vic80-designs/vic80_iButton_copier/Readme.md

# 🔑 Умный автономный копировщик 1-Wire ключей DS1990 на ATmega8 (asm)

Универсальный портативный дубликатор электронных ключей формата DS1990 (iButton), написанный на чистом низкоуровневом ассемблере AVR. Главная отличительная особенность проекта — функция **ручного поразрядного ввода уникального ID**, позволяющая создать работающий дубликат на болванке даже в том случае, если оригинальный ключ был утерян.

Проект разработан в рамках концепции "чистого DIY" (минималистичное железо и максимальная оптимизация кода), полностью автономен и проверен в реальной эксплуатации.

## 🚀 Ключевые особенности

* **Копирование без оригинала:** Возможность вручную набрать 64-битный код ключа (например, по записям из базы ТСЖ, ЖКХ или договора) и зашить его в болванку.
* **Аппаратный минимализм:** Всё управление завязано всего на три тактовые кнопки, а логика переходов реализована на базе эффективного конечного автомата (state machine) на ассемблере.
* **Автоматический расчет CRC-8:** При ручном вводе или редактировании идентификатора, байт контрольной суммы (два самых левых HEX-символа на дисплее) пересчитывается автоматически «на лету» по алгоритму Далласа. Отредактировать его вручную или ошибиться в контрольной сумме невозможно.
* **Интеллектуальная подсветка:** Реализован софтверный таймер активности. Если в течение 3 секунд устройство не используется (нет нажатий клавиш или операций чтения/записи), подсветка экрана WH1602 плавно гаснет для экономии энергии. При любом действии она мгновенно просыпается.
* **Программная локализация:** Интерфейс полностью русифицирован. Для дисплеев без встроенной поддержки кириллицы недостающие русские символы динамически генерируются и прописываются в CGRAM память контроллера HD44780 при старте.
* **Эргономичная индикация:** Считыватель снабжен двухцветным светодиодом (красный/зеленый) и пьезоэлектрическим зуммером, которые наглядно сигнализируют о статусе операции: долгий одиночный писк (успех) или серия из 5 коротких сигналов (ошибка).

## 📊 Режимы работы устройства

Переключение между режимами осуществляется кнопками «Влево» / «Вправо» по циклическому списку в верхнем ряду дисплея (выбираемый режим выделен угловыми скобками `< >`). Активация режима — по кнопке «Ввод» (при этом скобки исчезают).

1. **`< ЧТЕНИЕ >`** — Ожидание прикладывания оригинального ключа DS1990. При успешном чтении HEX-код выводится в нижнюю строку и сохраняется в оперативной памяти устройства до выключения питания.
2. **`< ЗАПИСЬ >`** — Режим прошивки болванок (поддерживаются RW1990 / TM01). Если память пуста, на экране на 3 секунды высветится надпись `ПУСТО` и прибор вернется в меню. Если же код в памяти есть, светодиод замигает, приглашая к действию: прислоняем болванку — и готово.
3. **`< РЕДАКТИРОВАНИЕ >`** — Поразрядный HEX-ввод. Кнопками «Влево» / «Вправо» выбирается полубайт (подсвечивается нижним подчеркиванием `_`), по нажатию кнопки «Ввод» курсор меняется на мигающий квадрат, позволяя изменять значение от `0` до `F`. Выход из режима — удержание кнопки «Ввод» более 3 секунд.

## 📁 Структура репозитория

* 📁 **Firmware/Bin** — Готовая скомпилированная прошивка в формате `iButtonCopier.hex` для быстрой заливки в микроконтроллер.
* 📁 **Firmware/Source_Code** — Полноценный проект для среды **Microchip Studio (Atmel Studio)** со всеми исходными файлами на чистом ассемблере AVR (`.asm`).
* 📁 **Schematics** — Принципиальная электрическая схема устройства, выполненная в среде EasyEDA. Доступна в форматах **PDF** (для качественной печати) и **PNG** (для быстрого просмотра).
* 📁 **PCB** — Файлы печатной платы: стандартизированный Gerber-архив в формате `.zip` для заказа плат на фабриках (JLCPCB, NextPCB и др.).

## ⚙ Настройка Fuse-битов при прошивке (Критически важно!)

Для правильной работы программных задержек протокола 1-Wire и таймингов опроса дисплея, микроконтроллер ATmega8 должен тактоваться от **внешнего кварцевого резонатора на 4.0 МГц** с конденсаторами обвязки. Наличие или настройка встроенного BOD-детектора в данном проекте роли не играет, так как данные в EEPROM не записываются.

Рекомендуемые конфигурационные байты фьюзов для внешнего кварца 4 МГц:

| Программа / Метод | Low Fuse | High Fuse |
| :--- | :---: | :---: |
| **AVRDUDE / Консоль** | **0xED** | **0xD9** |
| **eXtreme Burner** | **0xED** | **0xD9** |
| **AVR8 Burn-O-Mat** | **ED** | **D9** |

*Примечание: Выставленный Low Fuse 0xED настраивает МК на работу от внешнего среднечастотного кварца (CKSEL=1101) с максимальным временем задержки старта (SUT=10) для стабильного запуска генератора. Перед прошивкой обязательно сверяйтесь с картой фьюзов вашей конкретной утилиты.*

## 🔌 Рекомендации по схемотехнике и питанию

* **Управление узлами:** Для разгрузки портов ввода-вывода ATmega8 управление пьезоэлектрическим зуммером со встроенным генератором реализовано через классический транзисторный ключ (n-p-n). 
* **Подсветка LCD:** Ток подсветки экранов WH1602 может достигать 100 мА. На финальной схеме управление подсветкой выведено через отдельный биполярный транзистор, что полностью исключает перегрузку и деградацию пинов МК.
* **Стабилизация напряжения:** Схема питания спроектирована на импульсном DC-DC стабилизаторе **MC34063**. Это обеспечивает высокий КПД при питании устройства от внешних источников напряжением 9–12 В или батарей типа «Крона», предотвращая избыточный нагрев элементов схемы, свойственный линейным стабилизаторам типа 7805.
* **Фильтрация:** Обязательно устанавливайте блокировочный керамический конденсатор номиналом 0.1 мкФ в непосредственной близости к выводам питания микроконтроллера `VCC` и `GND`.

## ⚠ Дисклеймер и техническое примечание

**Проект предоставляется на условиях «As Is» (Как есть).** Автор не несет никакой ответственности за возможный ущерб имуществу, СКУД-системам, третьим лицам или за любое неправомерное использование данного прибора. Устройство разработано исключительно в ознакомительных, исследовательских и легальных DIY-целях (создание дубликата ключа от собственного жилья при утере оригинала). Все манипуляции вы проводите на свой собственный страх и риск.

При модификации, копировании или распространении исходного кода данного проекта указание авторства (**vic80**) является обязательным.
