vic80-designs/vic80_iButton_copier/Schematics/Schematic_iButtonCopier.png

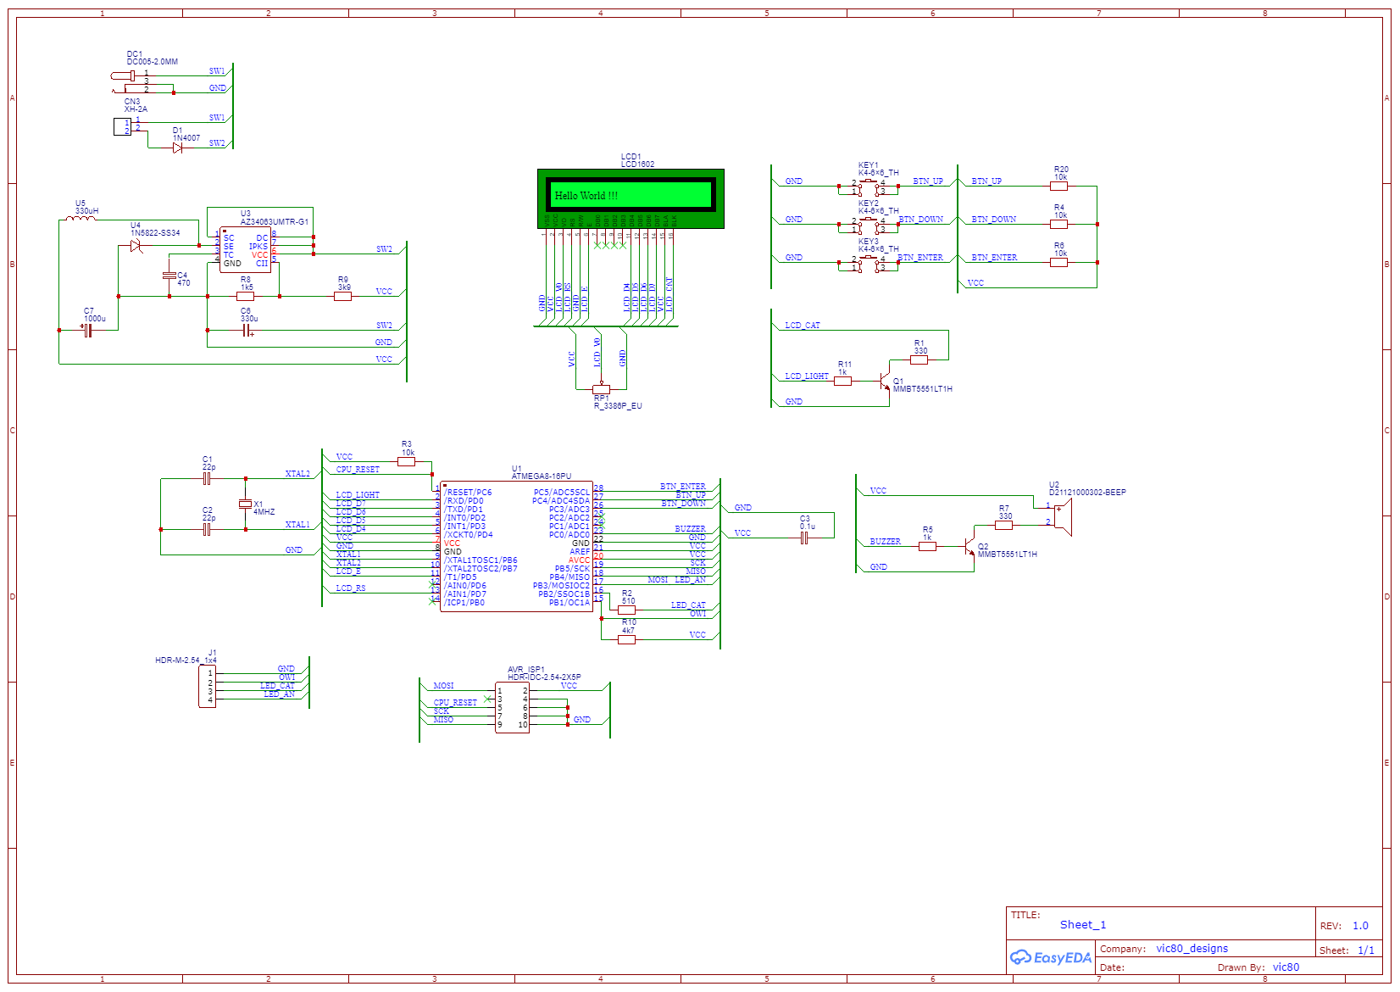
Schematics/Schematic_iButtonCopier.png
