vic80-designs/vic80_iButton_copier/Schematics/Schematic_iButtonCopier.pdf

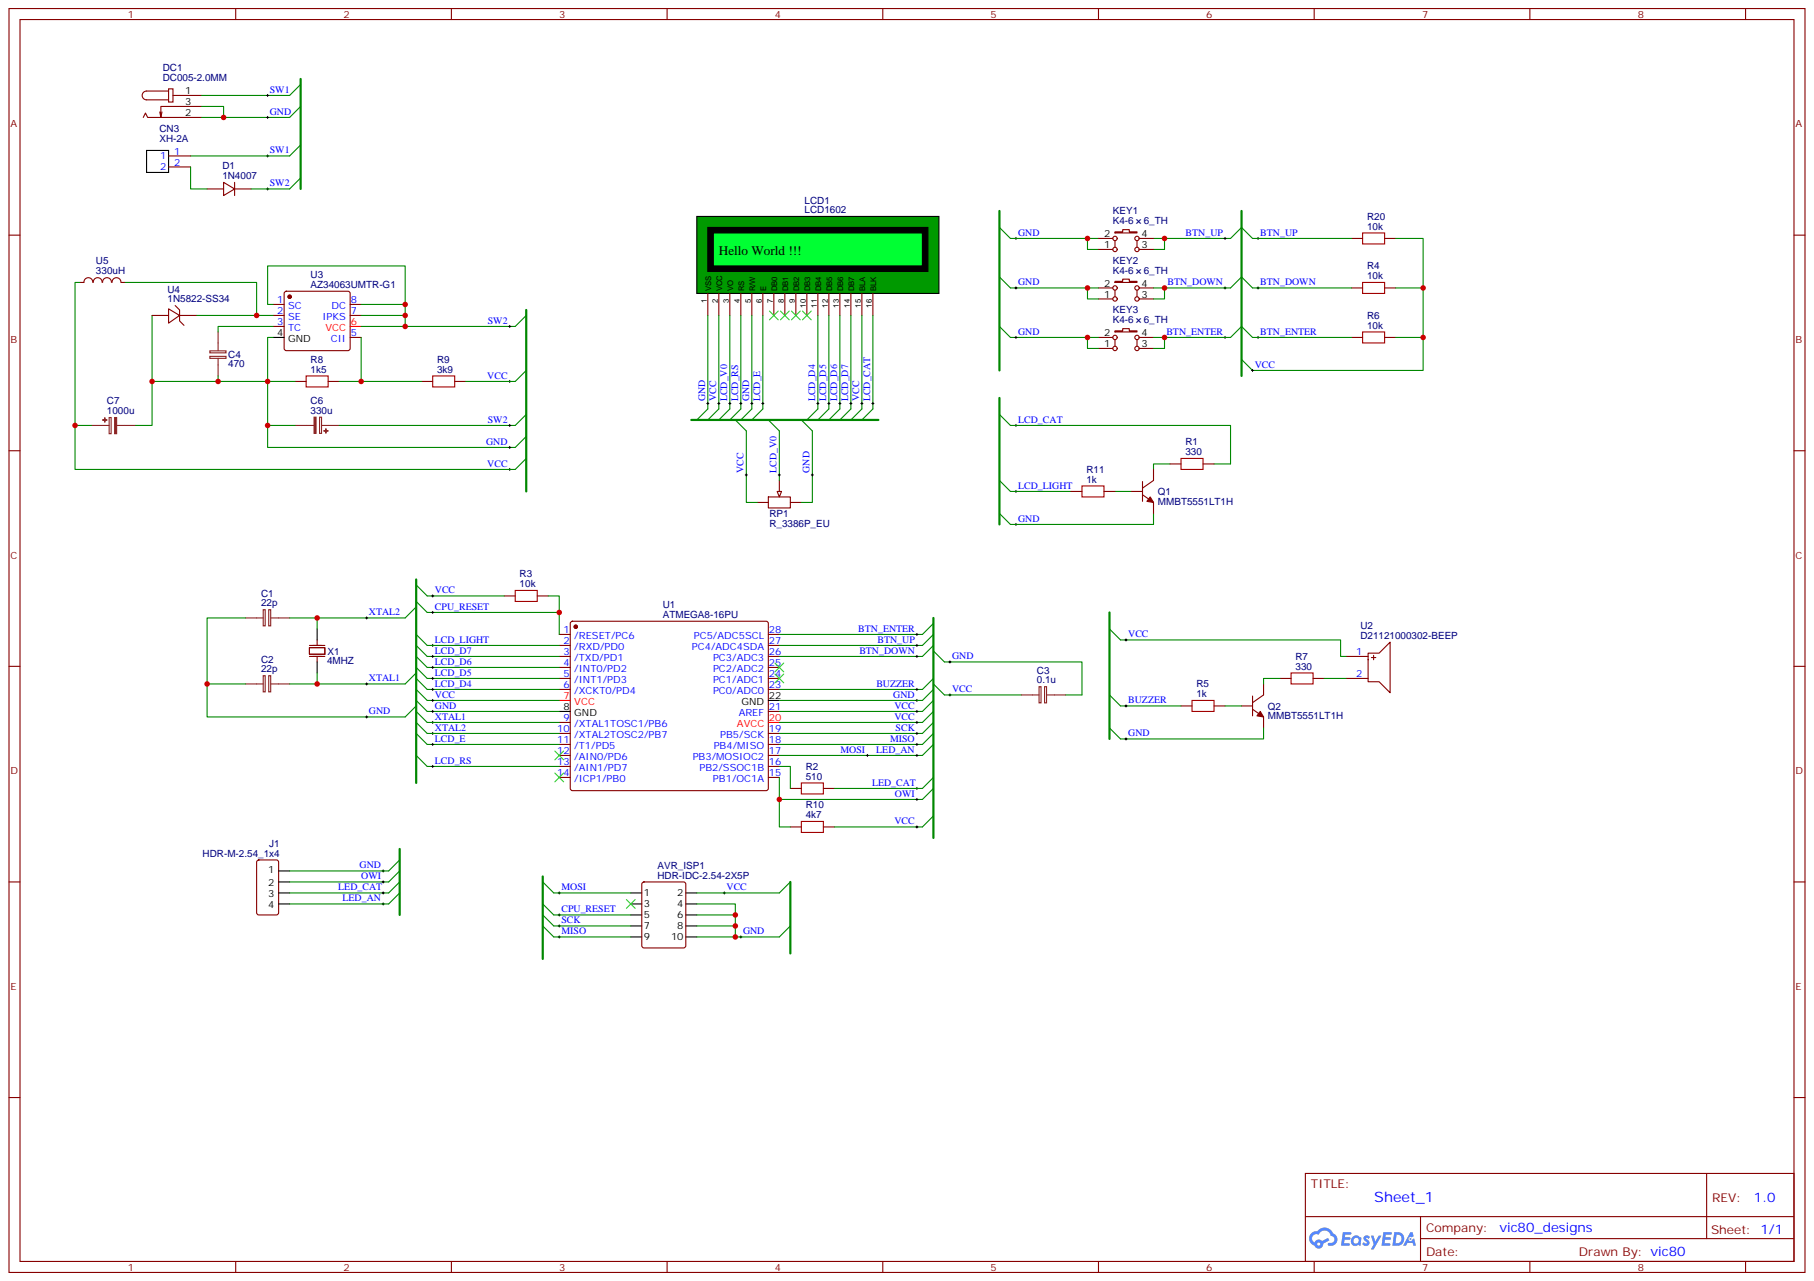
[picture p2: page 1]
